yohewi/NumAtreus/NumAtreusBUNKATSU/readme.md

NumAtreusの3Dプリント版ケースの分割バージョンです。  
  
Anycubicのi3mega等の出力サイズが20cm以下のプリンタで出力出来るように、  
前後左右の4パーツに分けています。  
※分割イメージ.png参照  
  
パーツの接合は各種接着剤（PLAであればアクリサンデー系）で  
接合してください。（ネジ穴等を作ってもよいと思います）  
  
なお、Boothで販売しているNumAtreusアフターパーツを使う場合は、  
他にProMicro、リセットスイッチ、ダイオード、ネジ類が必要です。  
  
パーツごとに色を変えても面白いと思いますので、色々試してください。  
  
よいNumAtreus DIYライフを！
