yohewi/NumAtreus/NumAtreus_mobile/readme.md

NumAtreus mobile STLについて

1.概要  
 本STLはNumAtreusを利用したモバイルPCの作成用STLです。  
 このまま出す場合、30㎝サイズのプリントが可能な3Dプリンタが必要でです。  
    
2.作成に必要なもの  
 3Dプリンタ  
 5インチディスプレイ  
  → 04jpg写真参照。コネクタを外すなど必要です。  
 Raspberry pi  
  → ネジ穴は3A+、3Bが使えますが、コネクタを外すなどカスタムが必要です  
 NumAtreusキーボード  
  → https://booth.pm/ja/items/1790931  
  → Kailh Chocスイッチが必要です。MXの場合蓋側が閉まらないです。  
 リチウムイオンポリマー電池  
 充電用基板  
  → 例 TP4056  
 電源オンオフ用スライドスイッチ  
  → 例 SS-22F25-G4  
 各種ケーブル  
  → 作例では直角のHDMIケーブル30㎝を利用しています。  
 ネジ類  
  → 左右のヒンジ部はM2の7-8mm長ネジです。蓋側の接続は、載せるプレートの厚みで調整してください。  
 トップ及びボトムを塞ぐプレート（塩ビ板等）  
  → 作例では下敷き0.7mmをカットして両面テープで張り付けています。  
  広い心  
   → 自分が作り直してやる！位のDIY精神でお願いします。
