yohewi/NumAtreus/atreus-master/01.png

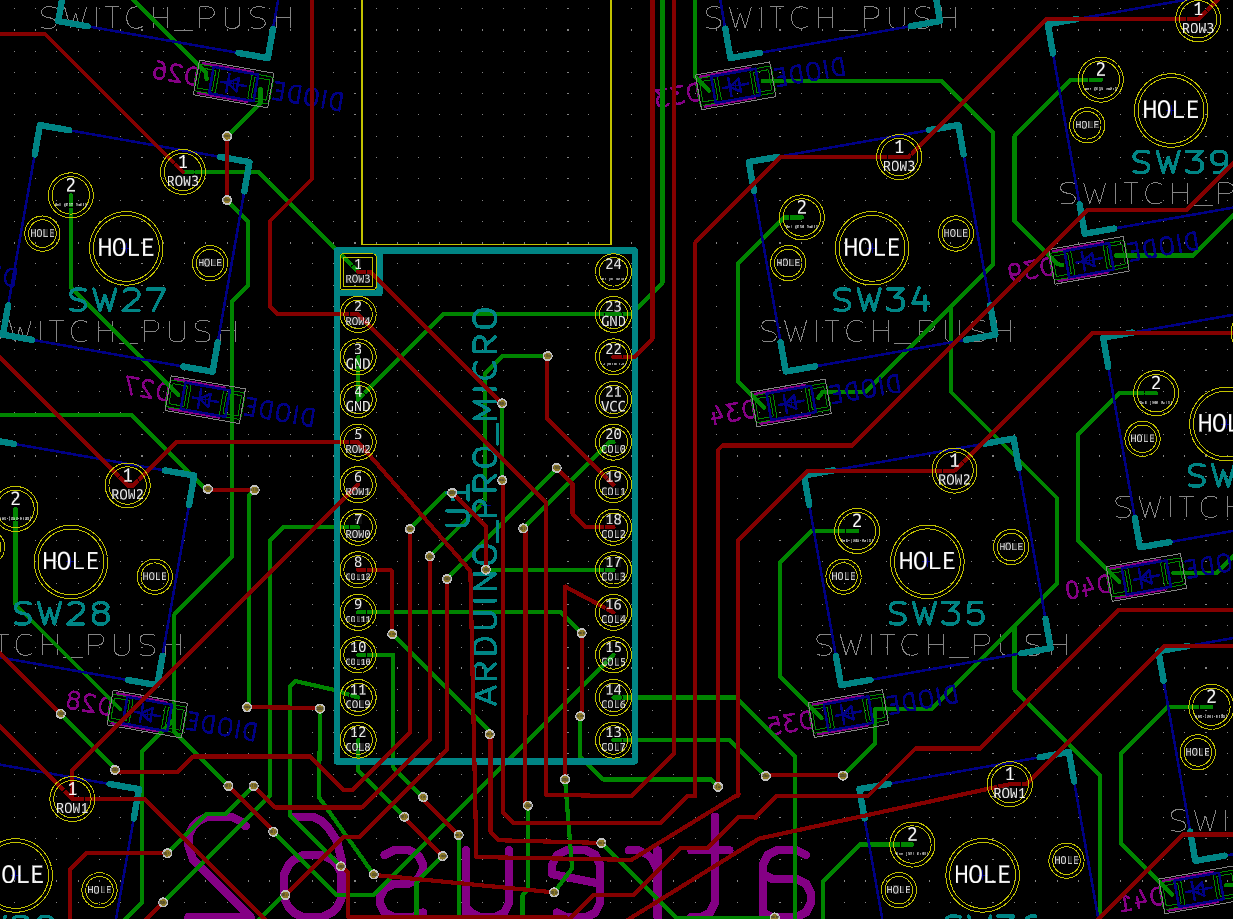
atreus-master/01.png
