yohewi/NumAtreus/atreus-master/02.png

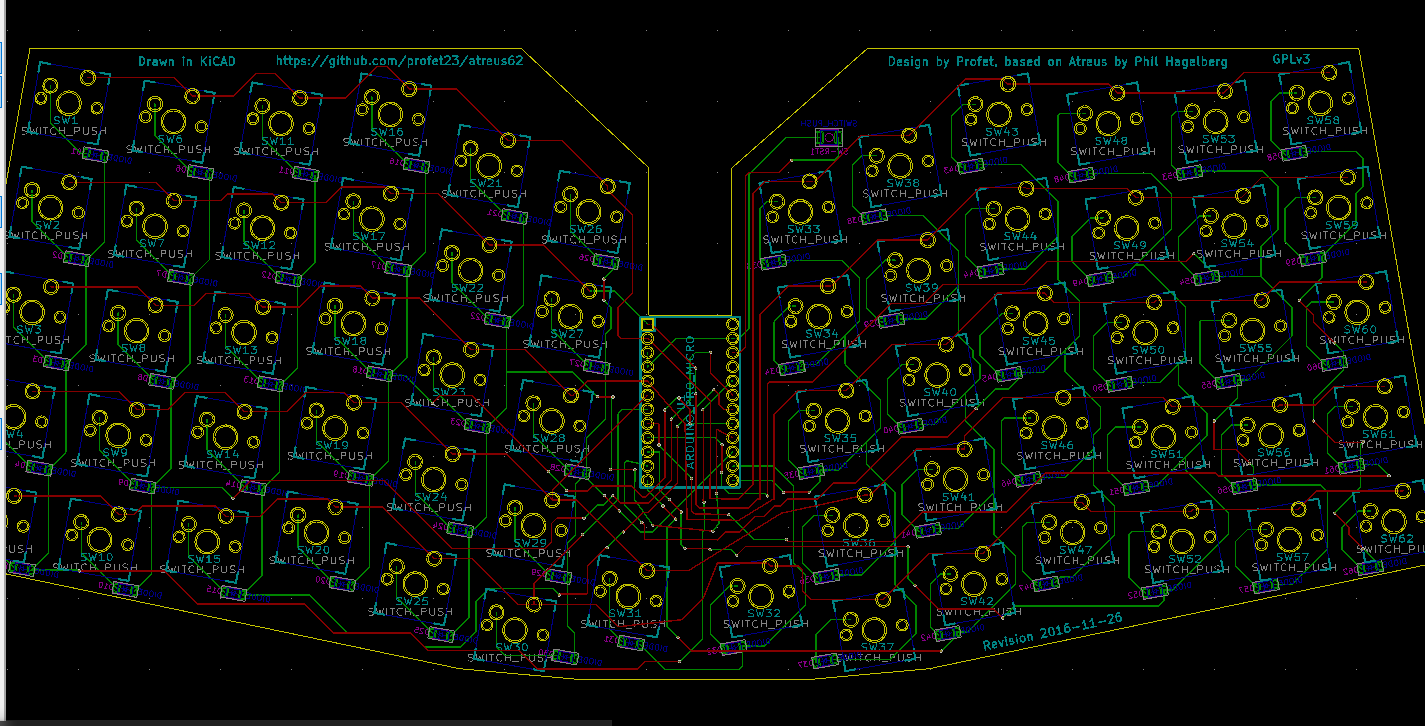
atreus-master/02.png
