yohewi/NumAtreus/NumAtreus_mobile/01.png

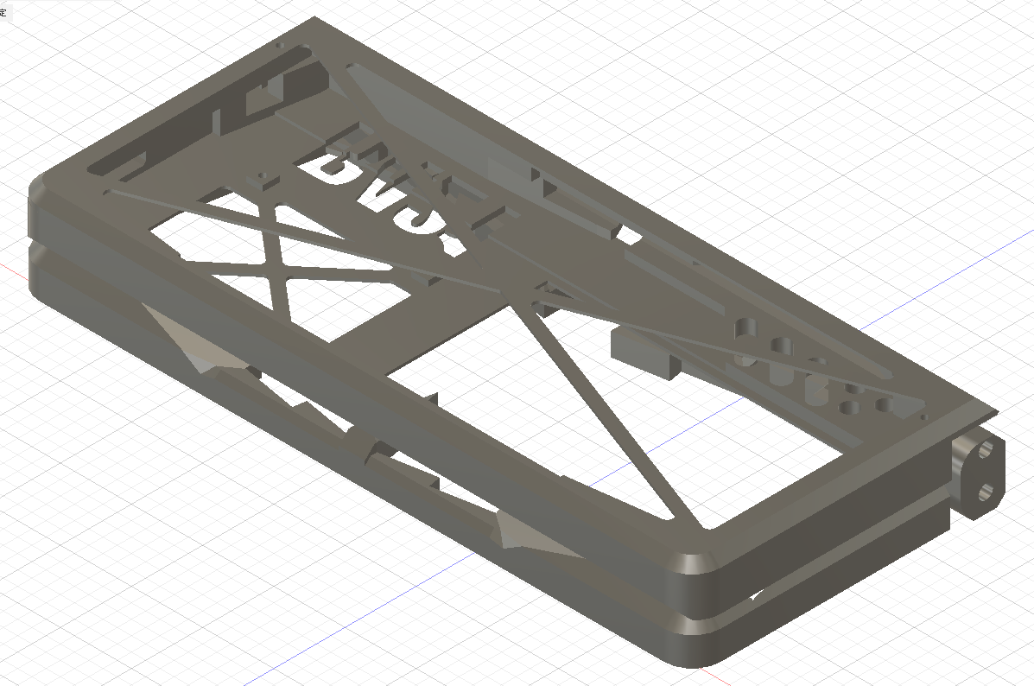
NumAtreus_mobile/01.png
