yohewi/NumAtreus/NumAtreus_mobile/02.jpg

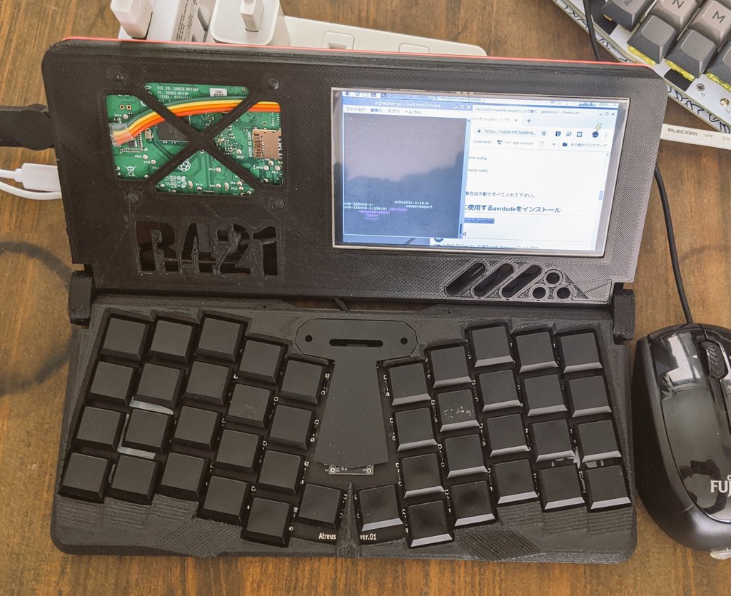
NumAtreus_mobile/02.jpg
