yohewi/NumAtreus/NumAtreus_mobile/03.jpg

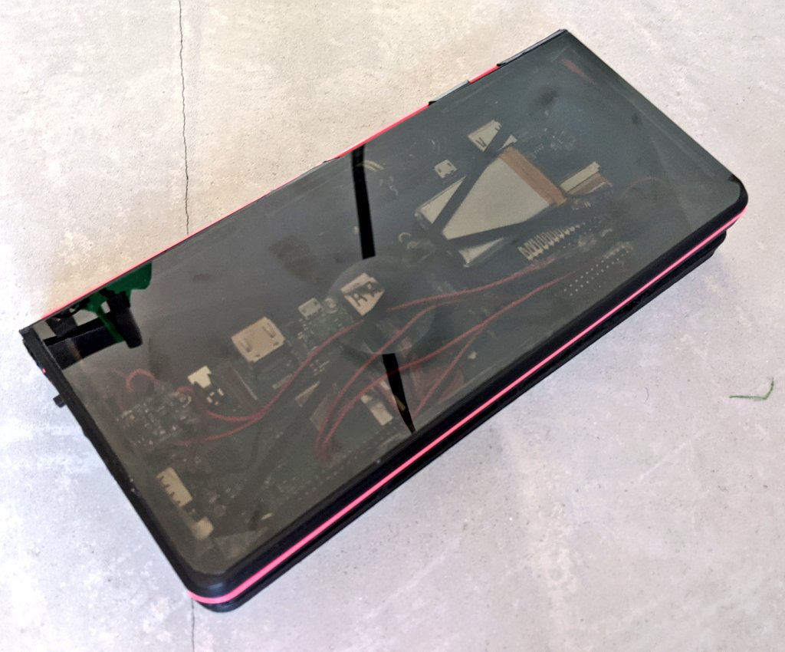
NumAtreus_mobile/03.jpg
