yohewi/NumAtreus/NumAtreus_mobile/04.jpg

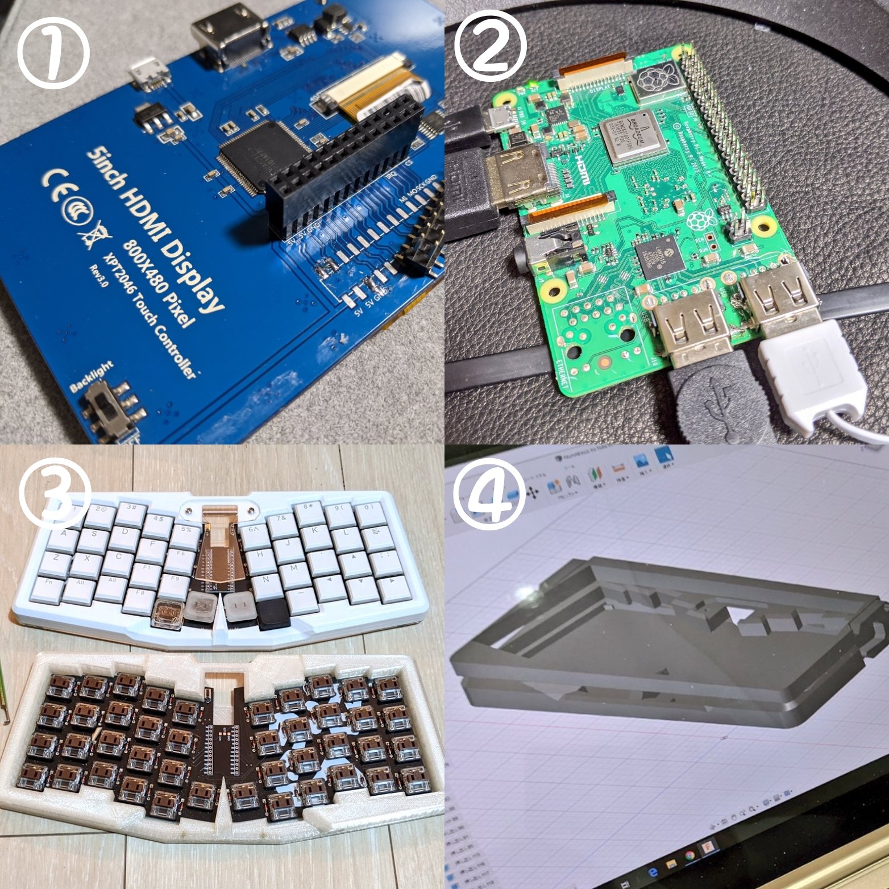
NumAtreus_mobile/04.jpg
