yohewi/NumAtreus/NumAtreus_mobile/05.jpg

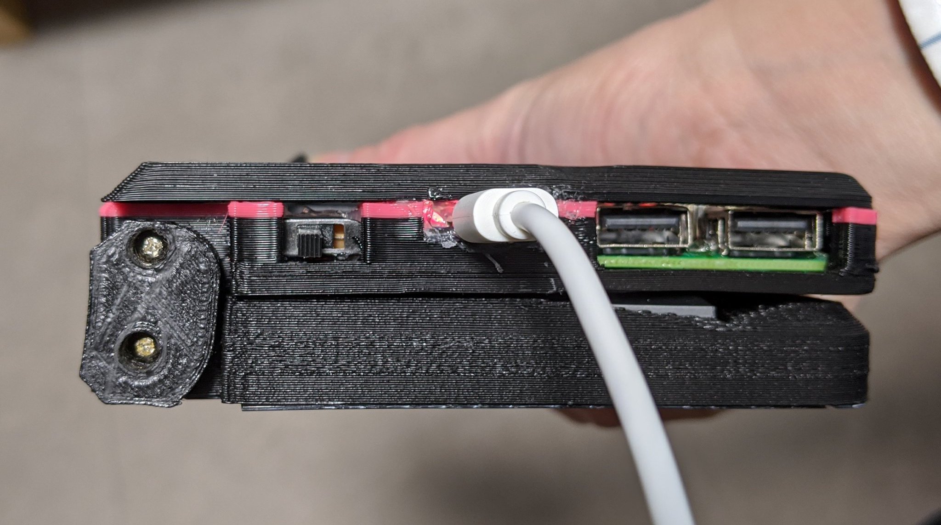
NumAtreus_mobile/05.jpg
