yohewi/NumAtreus/NumAtreusBUNKATSU/分割イメージ.png

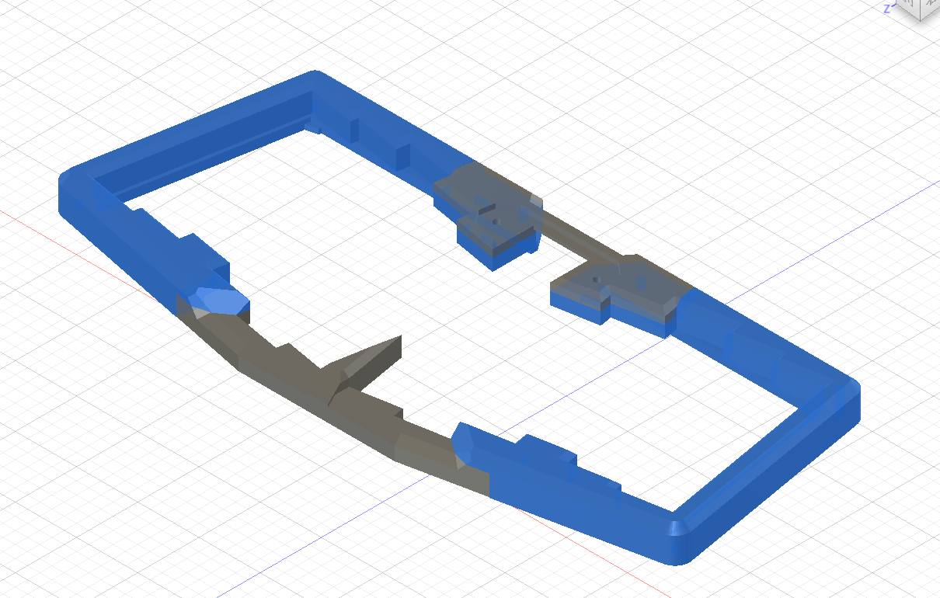
NumAtreusBUNKATSU/分割イメージ.png
