yohewi/NumAtreus/NumAtreus_mobile/3_R.stl

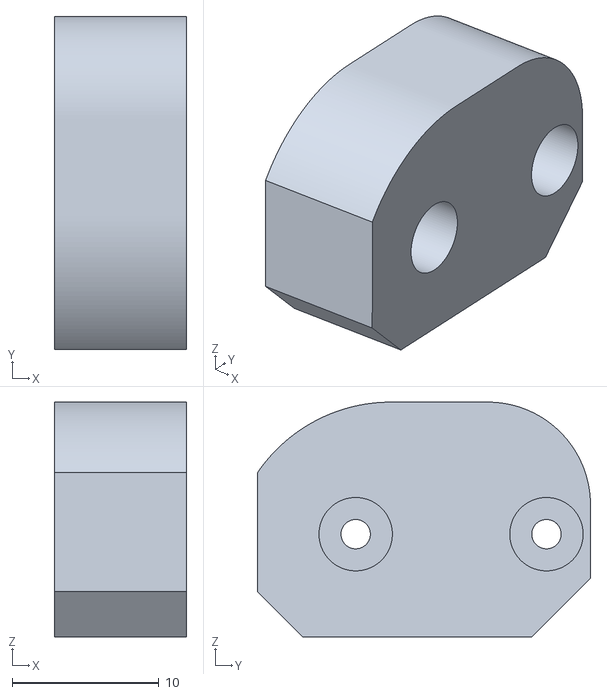
[picture p9: CAD file, 2020-04-19]
NumAtreus_mobile/3_R.stl
9.00 x 22.7 x 16.0
