yohewi/NumAtreus/NumAtreusBUNKATSU/bottom_migi.stl

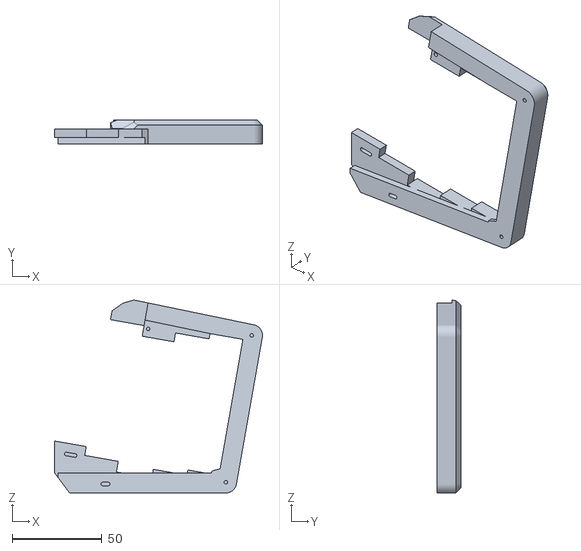
[picture p10: CAD file, 2020-05-14]
NumAtreusBUNKATSU/bottom_migi.stl
115.9 x 13.6 x 107.6
