yohewi/NumAtreus/NumAtreus_mobile/1_top1.stl

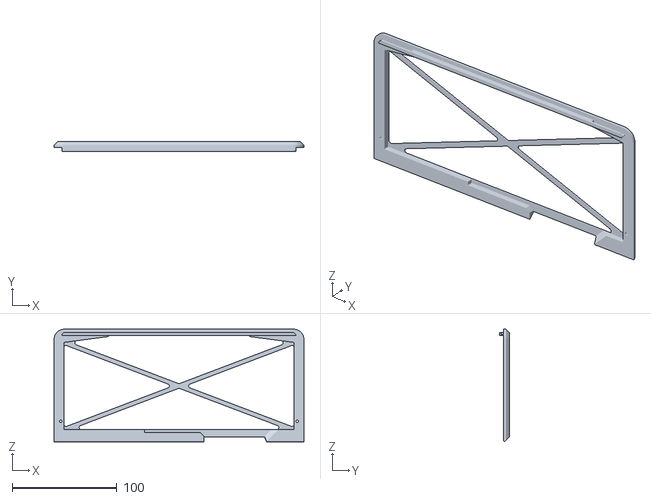
[picture p11: CAD file, 2020-04-19]
NumAtreus_mobile/1_top1.stl
239.2 x 9.50 x 107.8
