yohewi/NumAtreus/NumAtreusBUNKATSU/bottom_ushiro.stl

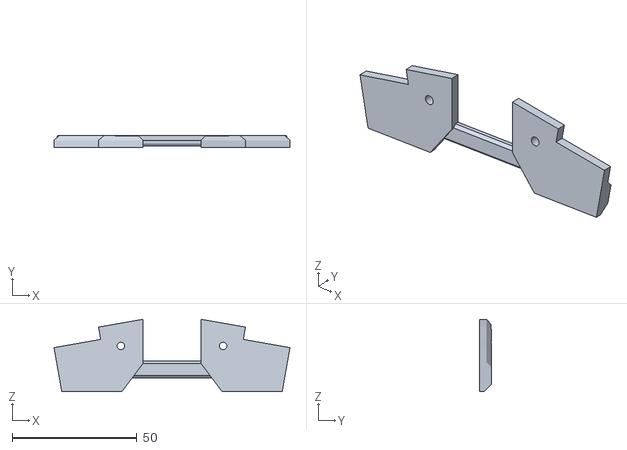
[picture p12: CAD file, 2020-05-14]
NumAtreusBUNKATSU/bottom_ushiro.stl
94.5 x 5.00 x 29.0
