yohewi/NumAtreus/NumAtreus_mobile/5_bottom.stl

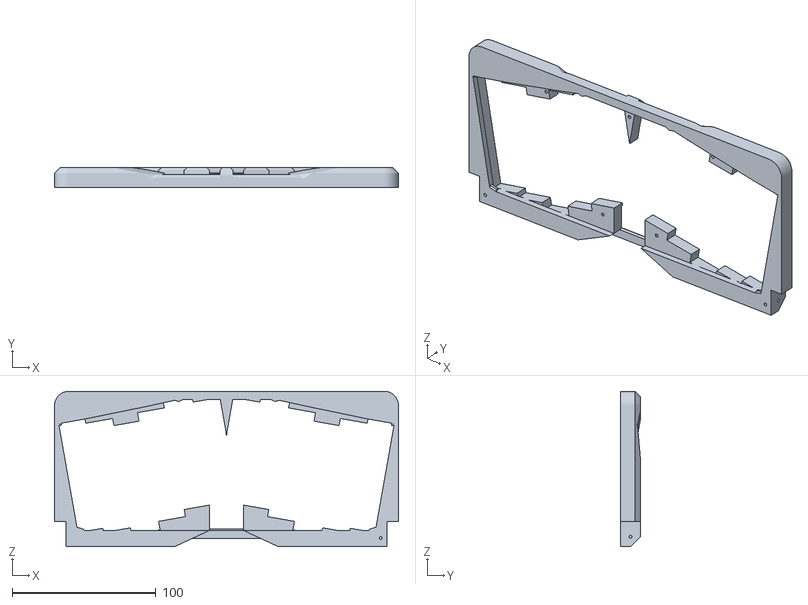
[picture p13: CAD file, 2020-04-19]
NumAtreus_mobile/5_bottom.stl
239.2 x 14.1 x 108.1
