yohewi/NumAtreus/NumAtreusBUNKATSU/bottom_mae.stl

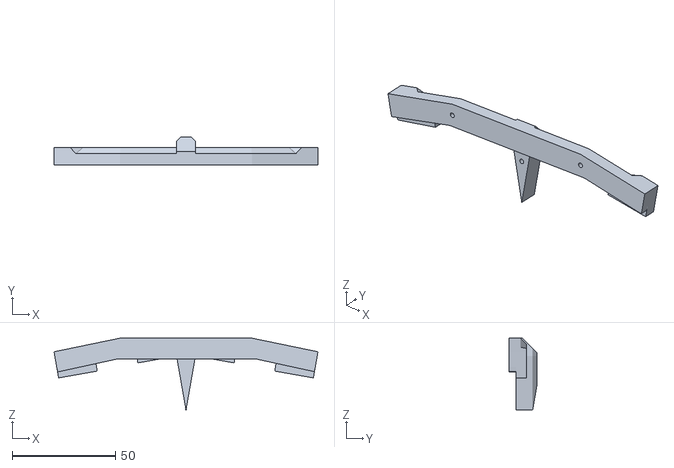
[picture p14: CAD file, 2020-05-14]
NumAtreusBUNKATSU/bottom_mae.stl
127.7 x 13.4 x 34.7
