yohewi/NumAtreus/NumAtreus_mobile/2_top2.stl

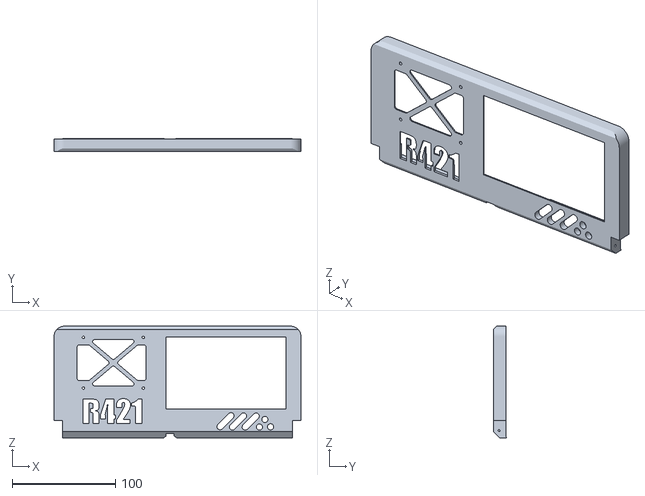
[picture p15: CAD file, 2020-04-19]
NumAtreus_mobile/2_top2.stl
239.2 x 12.7 x 108.1
