yohewi/NumAtreus/(list of files, cad)

Other CAD files:
NumAtreus_mobile/4_L.stl
NumAtreusBUNKATSU/bottom_hidari.stl
