yohewi/NumAtreus/JPG_buildguid/05d.jpg

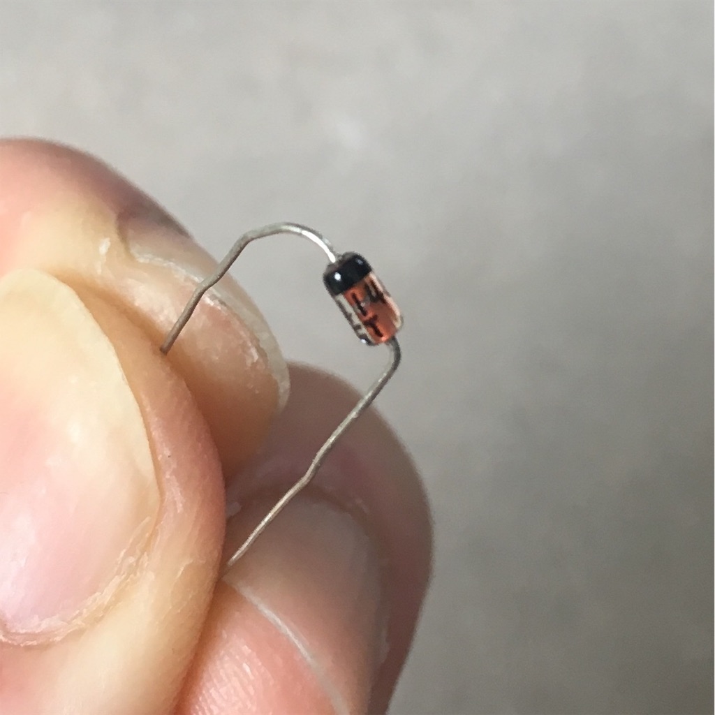
JPG_buildguid/05d.jpg
