yohewi/NumAtreus/NumAtreus2022_RPP/20220225_raspipico.pdf

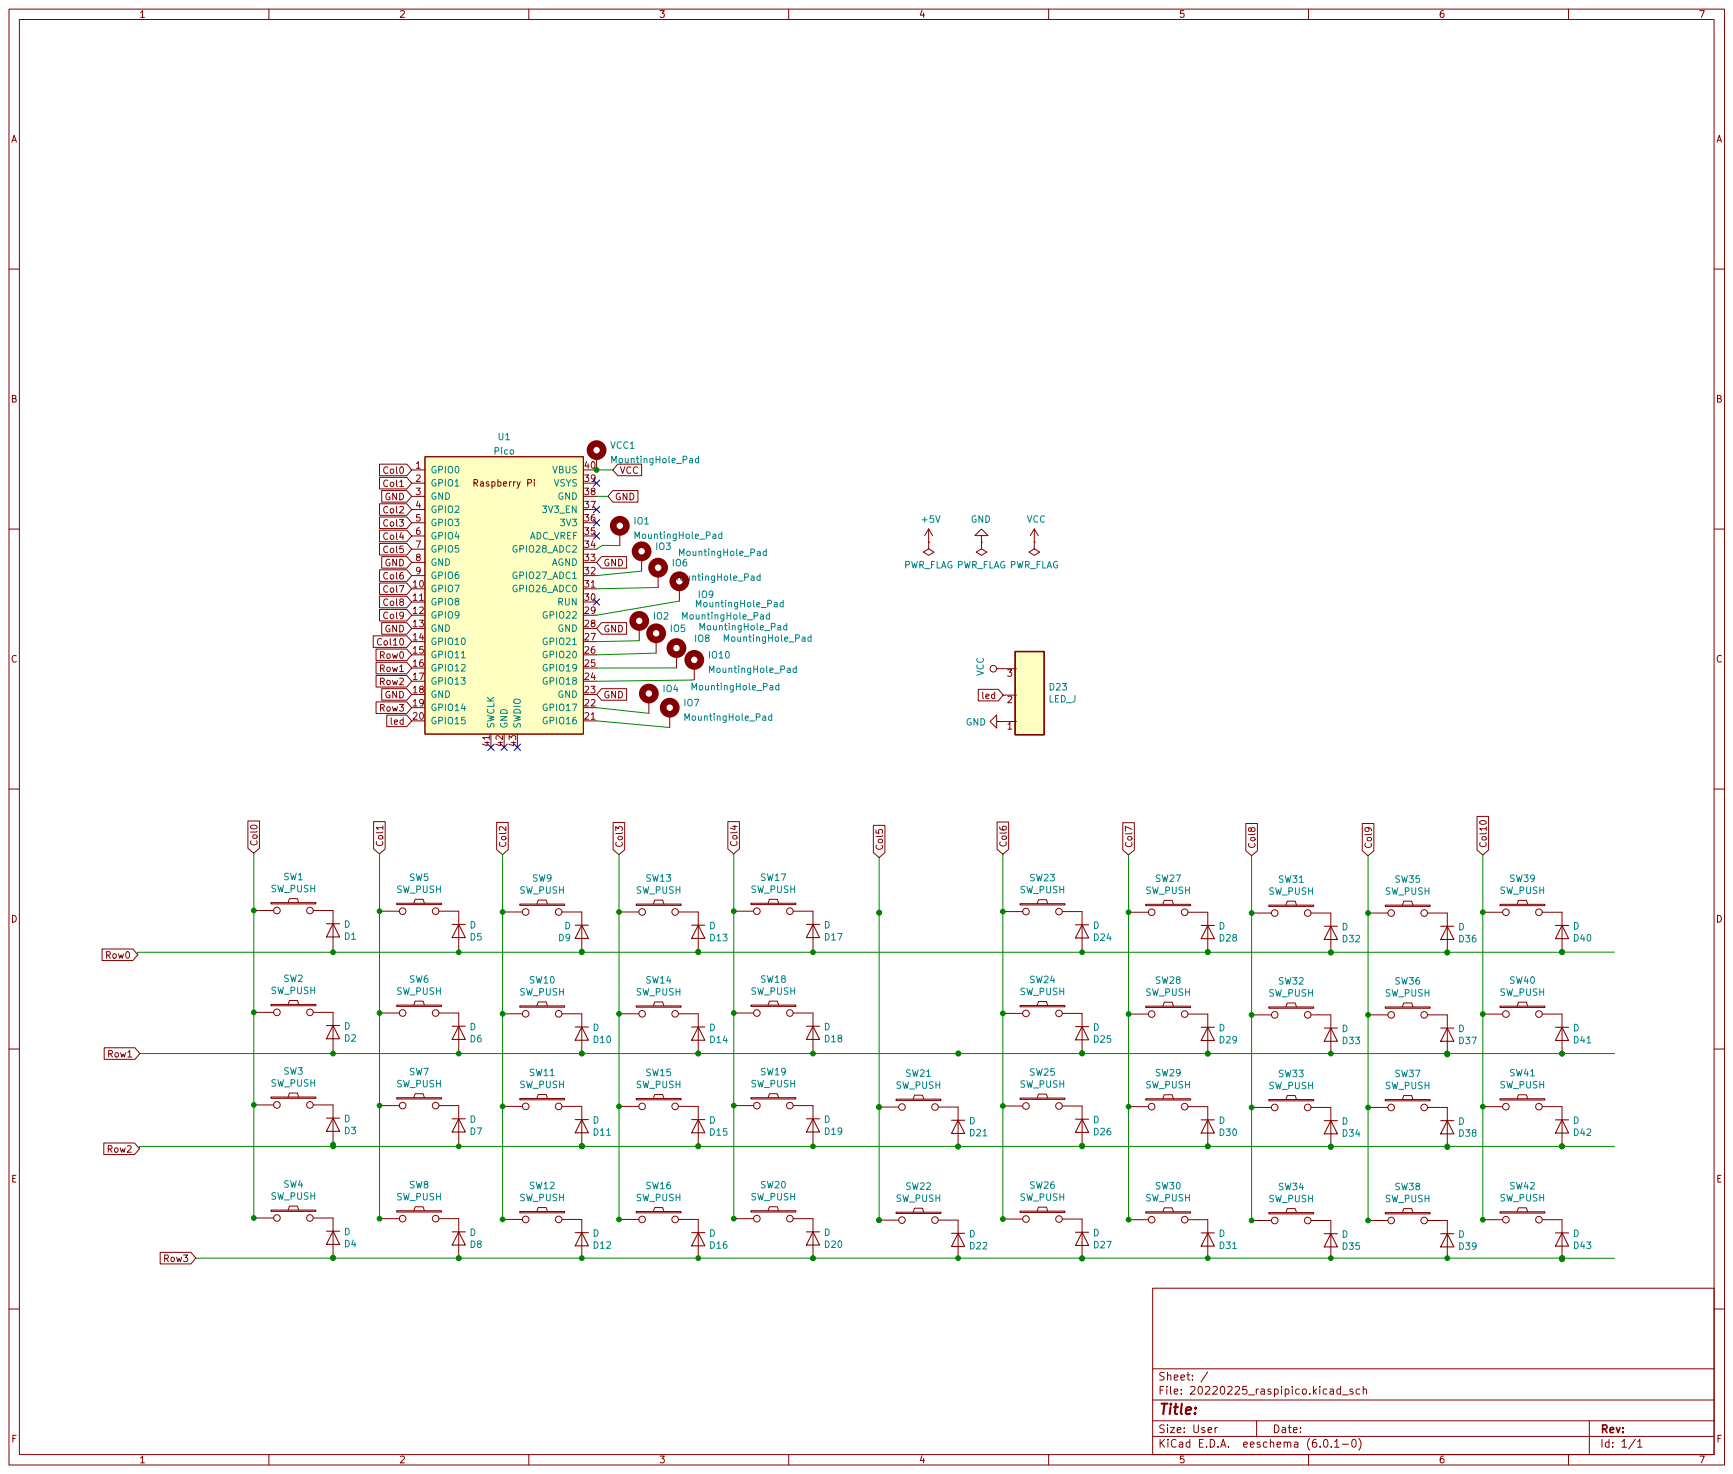
[picture p32: page 1]
