yohewi/NumAtreus/(commit log)

2020-04-19 NumAtreusを使ったモバイルPCのガワです。
    [1_top1.stl, 2_top2.stl, 3_R.stl, 4_L.stl, 5_bottom.stl]
2020-05-14 2020/5/14作成
    部品等を作成しました。
2020-05-14 スイッチについて追加
2020-05-14 NumAtreus3Dケースの分割について
    [bottom_hidari.stl, bottom_mae.stl, bottom_migi.stl, bottom_ushiro.stl]
2022-02-25 Raspberry Pi Pico 版のNumAtreusデータファイルです。
    Raspberry Pi Pico 版の回路図をアップロード
2022-02-25 Raspberry Pi Pico 版
    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
